KarpelesLab/multivolt/boards/lvl4/fab/lvl4_bottom.png

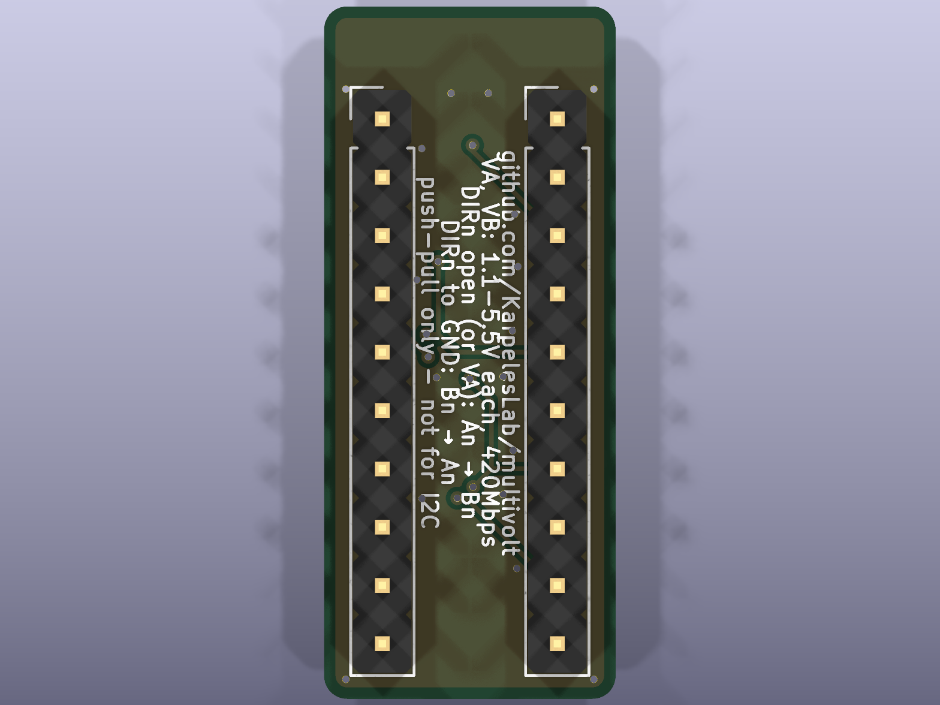
boards/lvl4/fab/lvl4_bottom.png
