KarpelesLab/multivolt/boards/lvl4/fab/lvl4_top.png

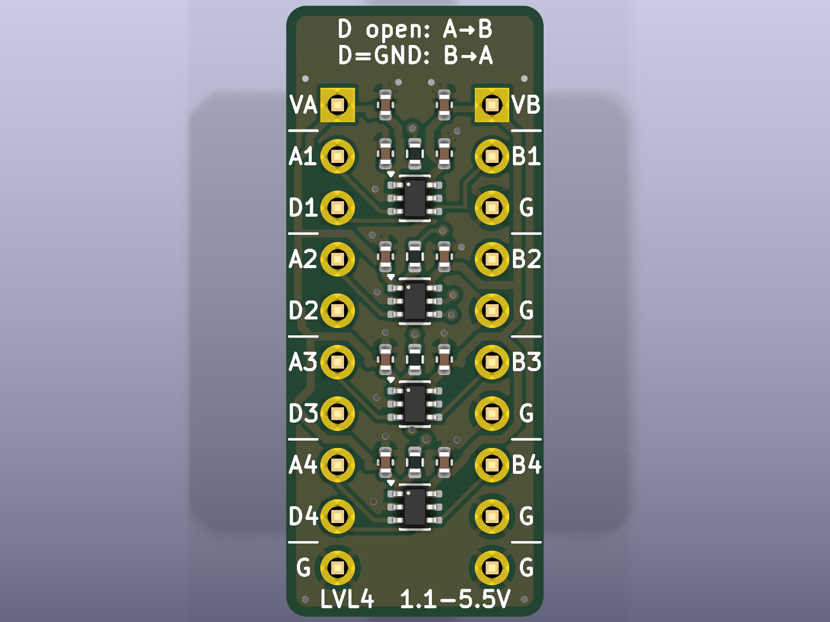
boards/lvl4/fab/lvl4_top.png
