KarpelesLab/multivolt/boards/mvpsu/fab/mvpsu_bottom.png

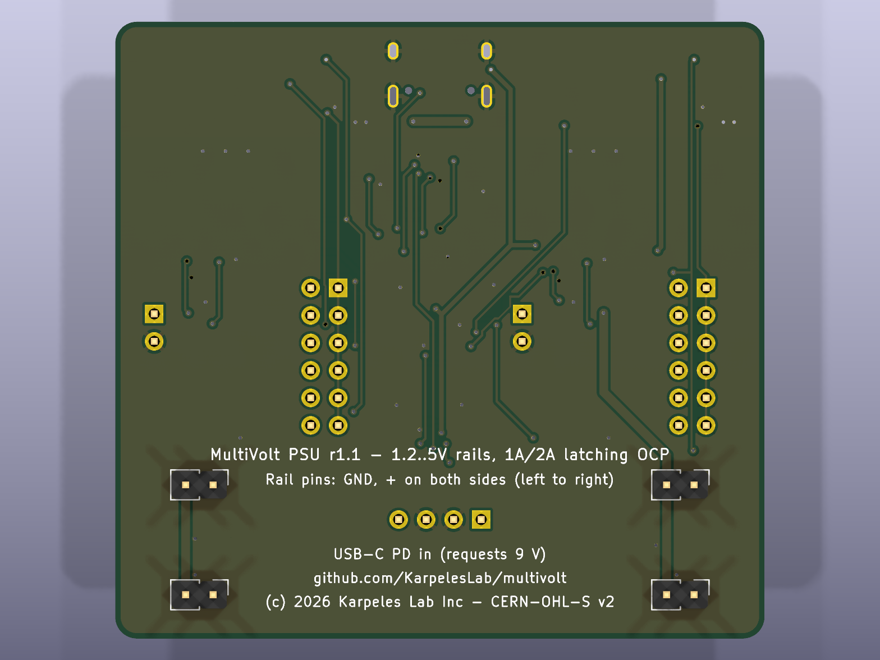
boards/mvpsu/fab/mvpsu_bottom.png
