KarpelesLab/multivolt/boards/mvpsu/fab/mvpsu_top.png

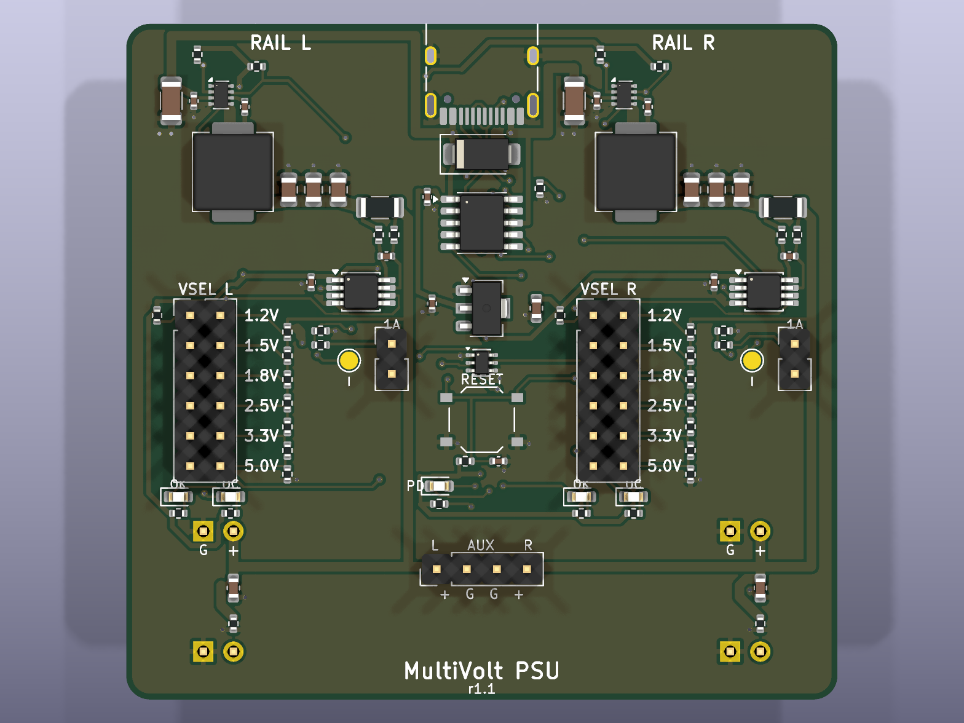
boards/mvpsu/fab/mvpsu_top.png
