KarpelesLab/multivolt/boards/mvpsu/fab/mvpsu_bom_jlc.csv

Comment | Designator | Footprint | LCSC Part #
USB-C | J1 | USB_C_Receptacle_HRO_TYPE-C-31-M-12 | C165948
SMAJ15A | D1 | D_SMA | C86819
CH224A | U1 | SSOP-10-1EP_3.9x4.9mm_P1mm_EP2.1x3.3mm | C42459160
1uF 25V | C1,C2 | C_0402_1005Metric | C52923
6.8k | R1 | R_0402_1005Metric | C25917
PD | D2 | LED_0603_1608Metric | C2287
1k | R2,R24,R27,R44,R47 | R_0402_1005Metric | C11702
HT7533-1 | U2 | SOT-89-3 | C14289
10uF | C3,C16,C36 | C_0603_1608Metric | C19702
2N7002DW | Q1 | SOT-363_SC-70-6 | C61840
RESET | SW1 | SW_Push_1P1T_XKB_TS-1187A | C318884
10k | R3 | R_0402_1005Metric | C25744
1uF | C4 | C_0402_1005Metric | C52923
TPS62933P | U3,U4 | SOT-583-8 | C5219254
22uF 25V | C10,C30 | C_1206_3216Metric | C12891
100nF | C11,C12,C17,C31,C32,C37 | C_0402_1005Metric | C1525
4.7uH | L1,L2 | L_Changjiang_FXL0630 | C167220
22uF 10V | C13,C14,C15,C33,C34,C35 | C_0805_2012Metric | C29277
50m | R10,R30 | R_1206_3216Metric | C127691
100k | R19,R20,R39,R40 | R_0402_1005Metric | C25741
INA301A1 | U5,U6 | VSSOP-8_3x3mm_P0.65mm | C471062
10 | R25,R26,R45,R46 | R_0402_1005Metric | C25077
4.7uF | C18,C38 | C_0402_1005Metric | C106859
24.9k | R21,R22,R41,R42 | R_0402_1005Metric | C138027
ILIM 1A | J11,J31 | PinHeader_1x02_P2.54mm_Vertical | C492401
6.34k | R11,R31 | R_0402_1005Metric | C5713274
2.43k | R12,R32 | R_0402_1005Metric | C830241
1.62k | R13,R33 | R_0402_1005Metric | C138038
2.26k | R14,R34 | R_0402_1005Metric | C226955
1.4k | R15,R35 | R_0402_1005Metric | C2974008
1.5k | R16,R36 | R_0402_1005Metric | C25867
2.94k | R17,R37 | R_0402_1005Metric | C42396634
1M | R18,R38 | R_0402_1005Metric | C26083
VSEL | J10,J30 | PinHeader_2x06_P2.54mm_Vertical | C492423
OK | D10,D30 | LED_0603_1608Metric | C2289
330 | R23,R43 | R_0402_1005Metric | C25104
OC | D11,D31 | LED_0603_1608Metric | C2286
RAIL L | J12,J13 | PinHeader_1x02_P2.54mm_Vertical | C492401
RAIL R | J32,J33 | PinHeader_1x02_P2.54mm_Vertical | C492401
AUX OUT | J2 | PinHeader_1x04_P2.54mm_Vertical | C2691448
