KarpelesLab/multivolt/boards/lvl4/fab/lvl4_bom_jlc.csv

Comment | Designator | Footprint | LCSC Part #
A side | J1 | PinHeader_1x10_P2.54mm_Vertical | C492409
B side | J2 | PinHeader_1x10_P2.54mm_Vertical | C492409
1uF | C1,C2 | C_0402_1005Metric | C52923
SN74LXC1T45DCK | U1,U2,U3,U4 | SOT-363_SC-70-6 | C5217888
100nF | C11,C12,C13,C14,C21,C22,C23,C24 | C_0402_1005Metric | C1525
100k | R1,R2,R3,R4 | R_0402_1005Metric | C25741
