KarpelesLab/multivolt/boards/mvpsu/fab/mvpsu_schematic.pdf

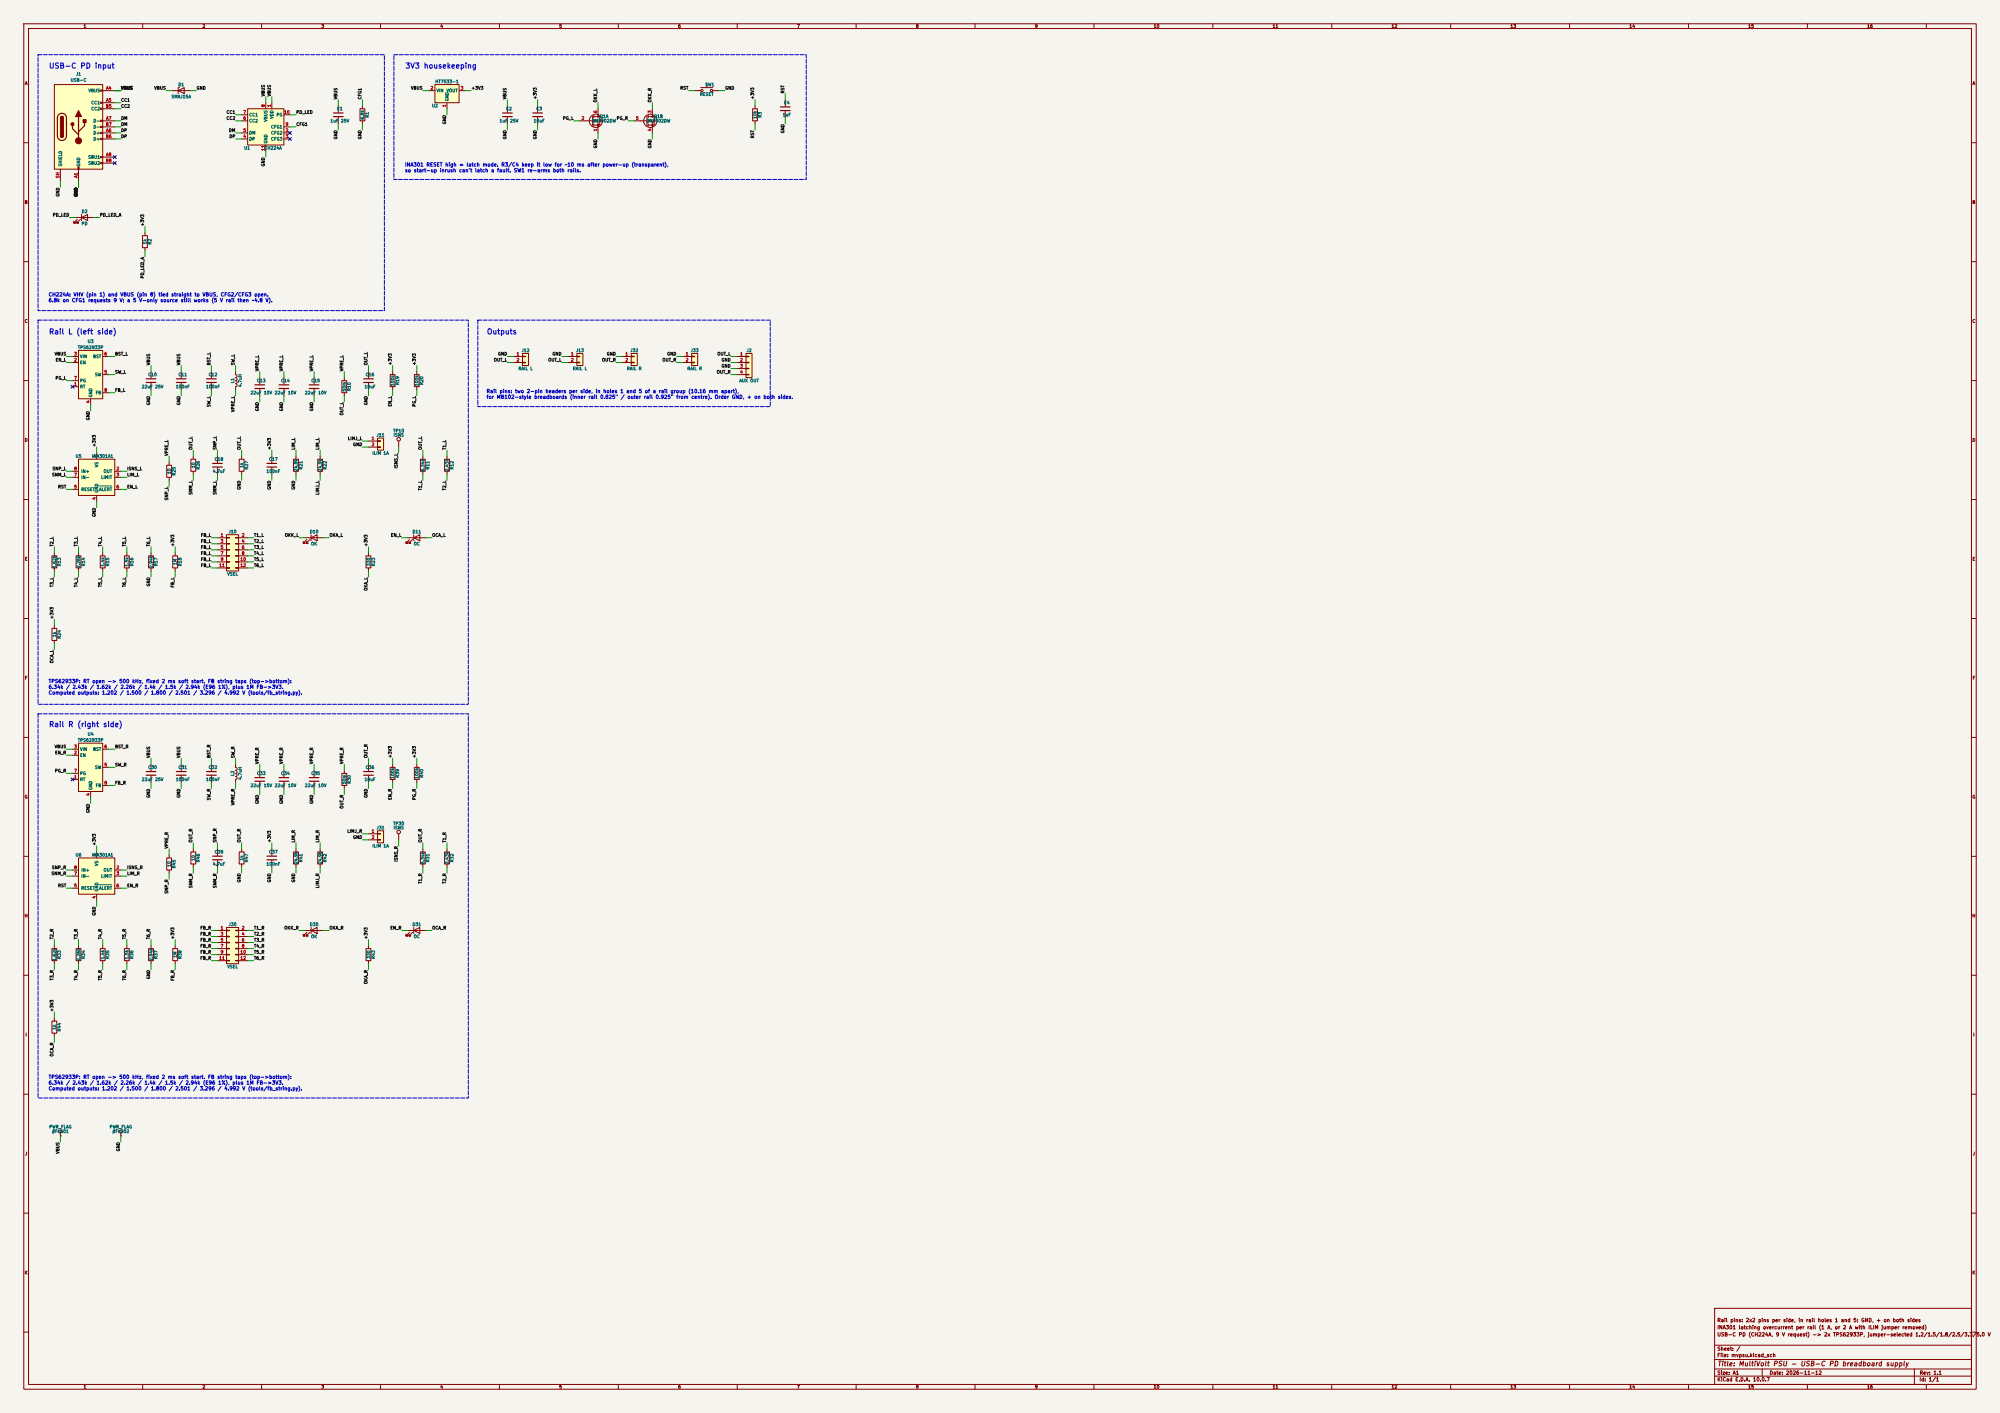
[picture p7: page 1]

INA301 RESET high = latch mode. R3/C4 keep it low for ~10 ms after power-up (transparent), so start-up inrush can't latch a fault. SW1 re-arms both rails.

CH224A: VHV (pin 1) and VBUS (pin 8) tied straight to VBUS, CFG2/CFG3 open.
6.8k on CFG1 requests 9 V; a 5 V-only source still works (5 V rail then ~4.8 V).

Rail pins: two 2-pin headers per side, in holes 1 and 5 of a rail group (10.16 mm apart),
for MB102-style breadboards (inner rail 0.825" / outer rail 0.925" from centre). Order GND, + on both sides.

TPS62933P: RT open -> 500 kHz, fixed 2 ms soft start. FB string taps (top->bottom):
6.34k / 2.43k / 1.62k / 2.26k / 1.4k / 1.5k / 2.94k (E96 1%), plus 1M FB->3V3.
Computed outputs: 1.202 / 1.500 / 1.800 / 2.501 / 3.296 / 4.992 V (tools/fb_string.py).

INA301 latching overcurrent per rail (1 A, or 2 A with ILIM jumper removed)
USB-C PD (CH224A, 9 V request) -> 2x TPS62933P, jumper-selected 1.2/1.5/1.8/2.5/3.3/5.0 V

Sheet: /
File: mvpsu.kicad_sch
Title: MultiVolt PSU - USB-C PD breadboard supply

Size: A1 | Rev: 1.1
KiCad E.D.A. 10.0.7 | Id: 1/1
