KarpelesLab/multivolt/boards/lvl4/fab/lvl4_schematic.pdf

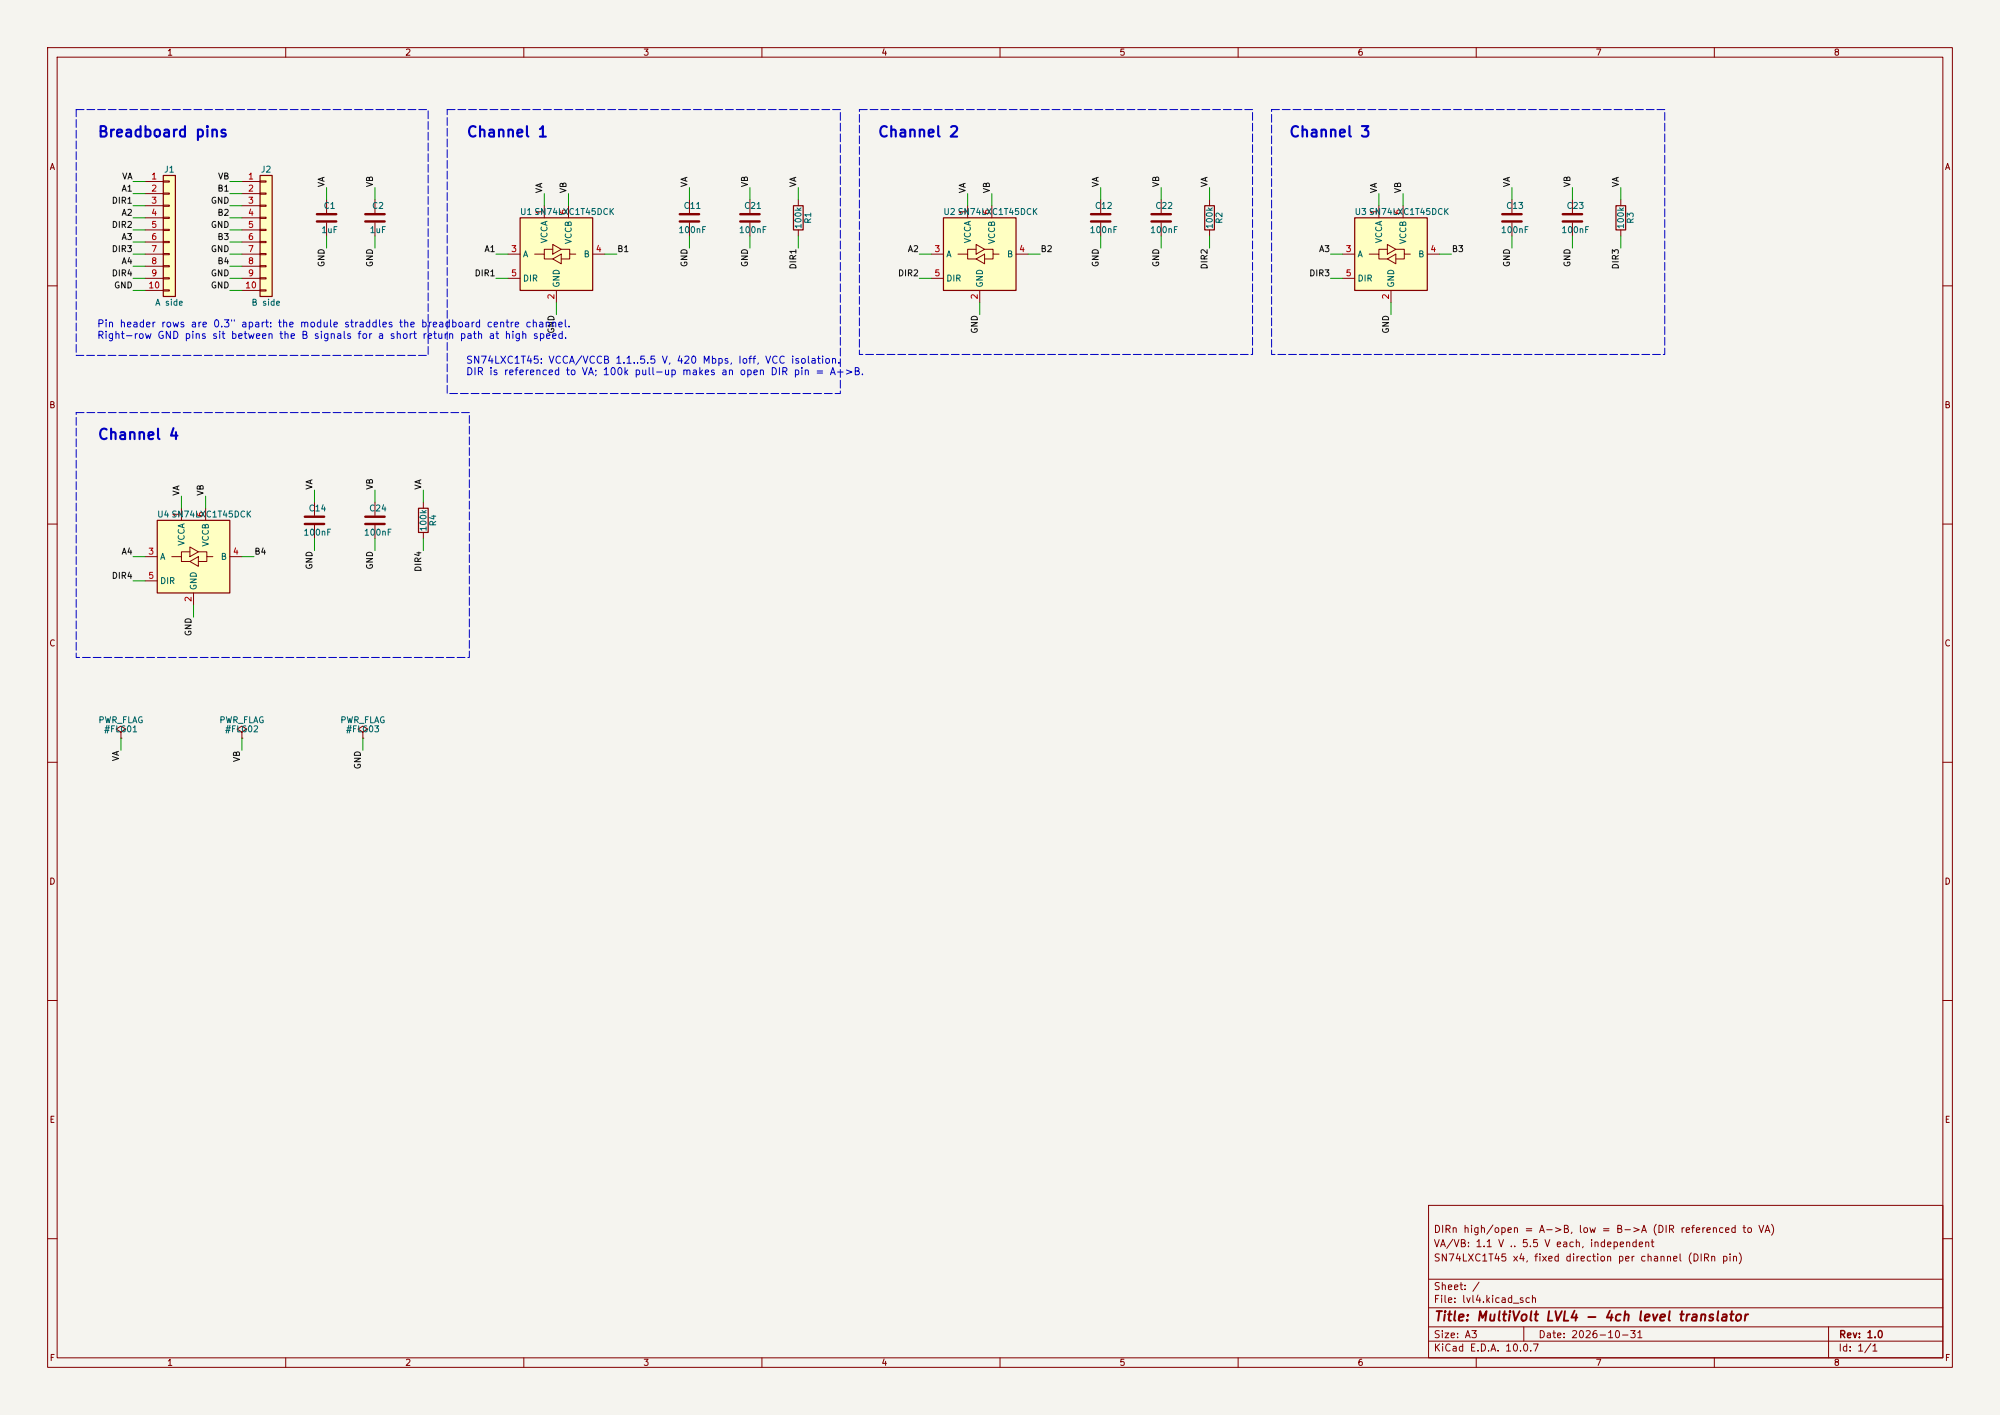
[picture p8: page 1]

Pin header rows are 0.3" apart: the module straddles the breadboard centre channel.
Right-row GND pins sit between the B signals for a short return path at high speed.

SN74LXC1T45: VCCA/VCCB 1.1..5.5 V, 420 Mbps, Ioff, VCC isolation.
DIR is referenced to VA; 100k pull-up makes an open DIR pin = A->B.

DIRn high/open = A->B, low = B->A (DIR referenced to VA)
VA/VB: 1.1 V .. 5.5 V each, independent
SN74LXC1T45 x4, fixed direction per channel (DIRn pin)

Sheet: /
File: lvl4.kicad_sch
Title: MultiVolt LVL4 - 4ch level translator

Size: A3 | Rev: 1.0 | F Date: 2026-10-31
KiCad E.D.A. 10.0.7 | Id: 1/1
