KarpelesLab/multivolt/boards/mvpsu/mvpsu.kicad_pcb

## KiCad design boards/mvpsu/mvpsu.kicad_pcb (2026-11-11)

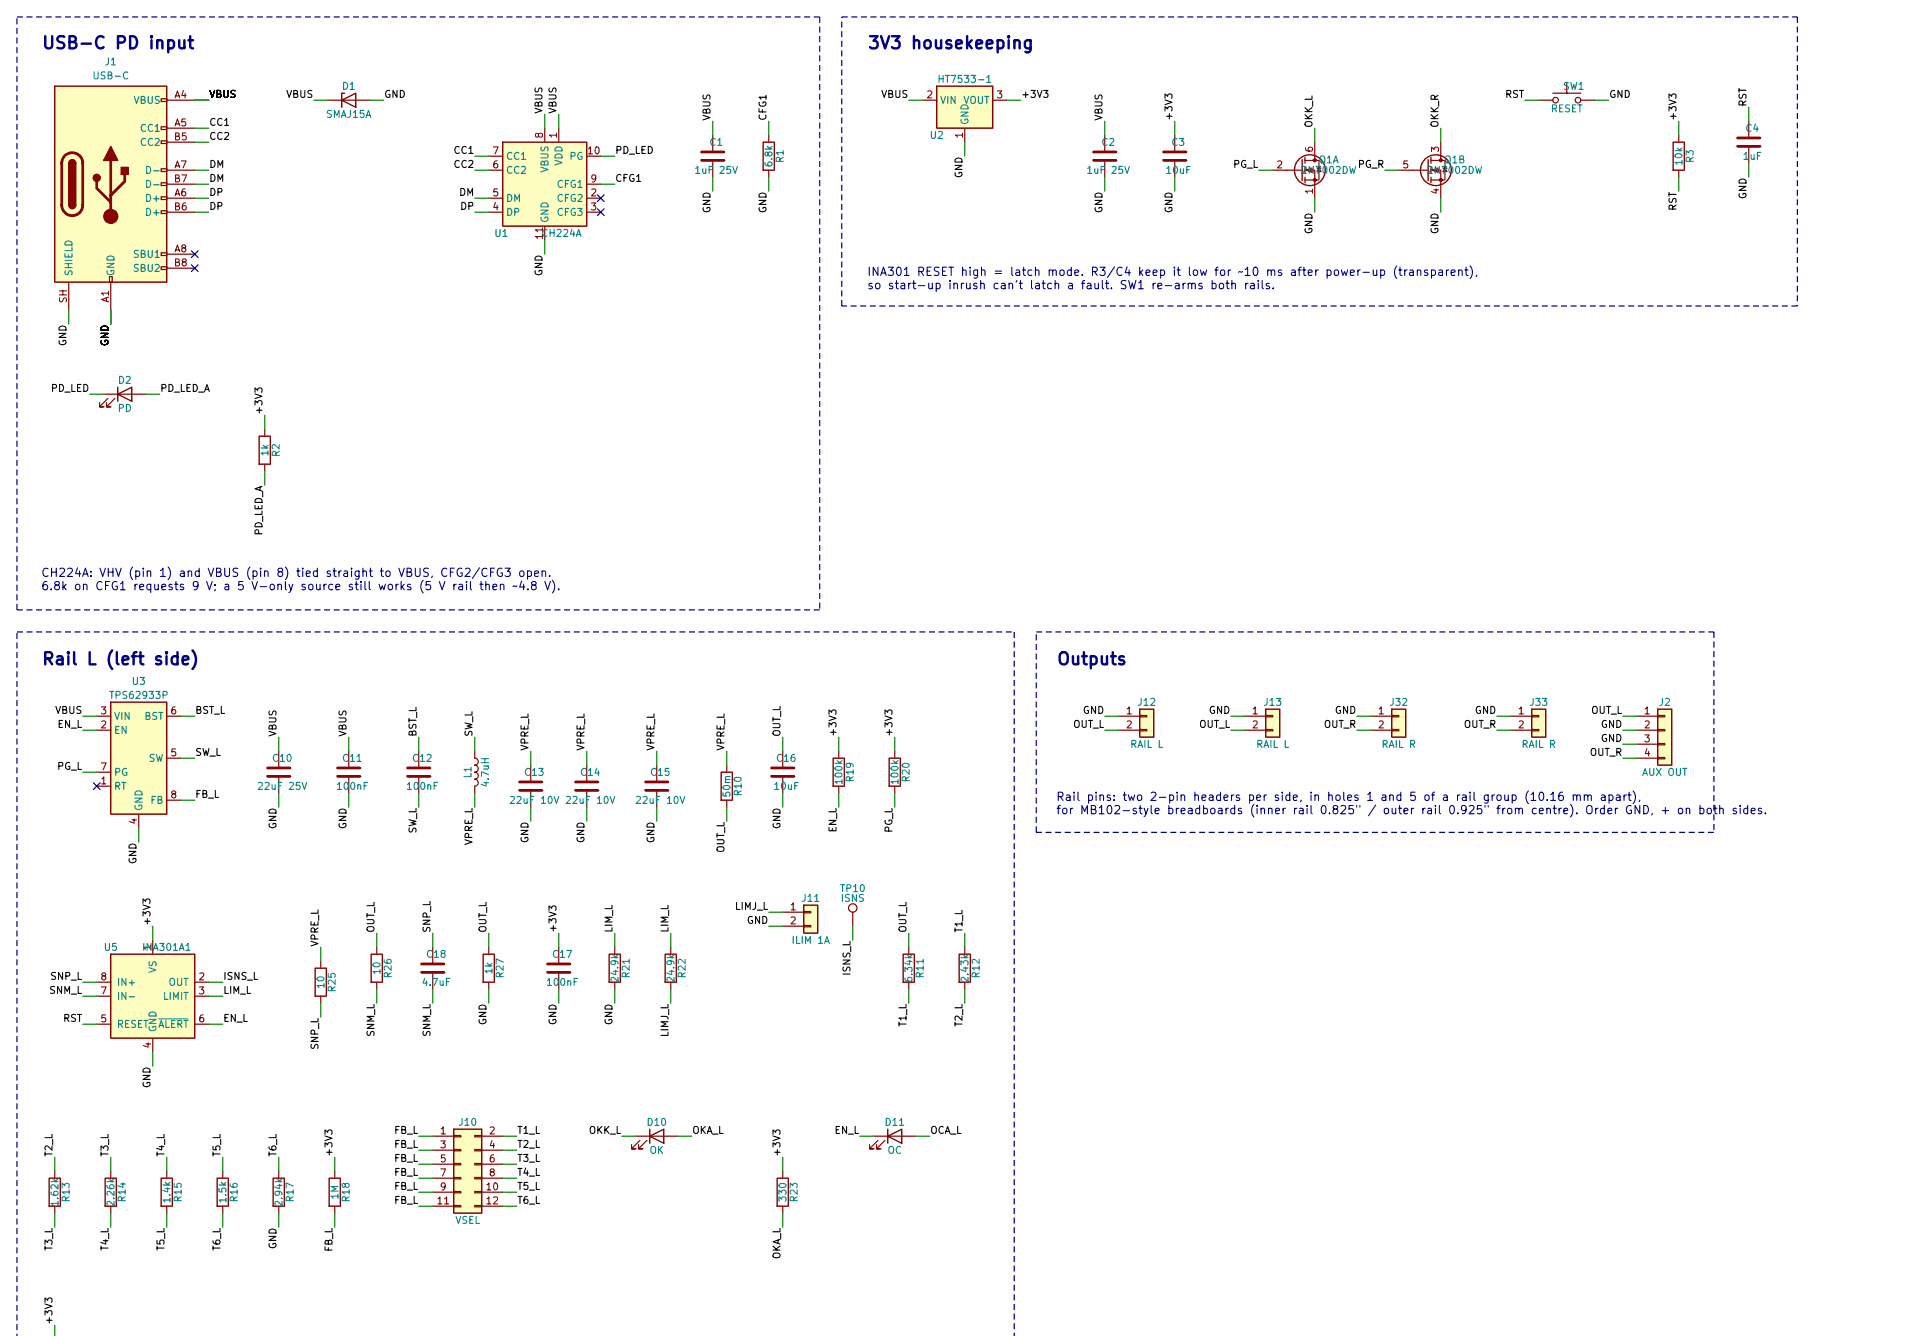
[picture p9: schematic mvpsu.kicad_sch, MultiVolt PSU - USB-C PD breadboard supply, part in row 1, column 1]

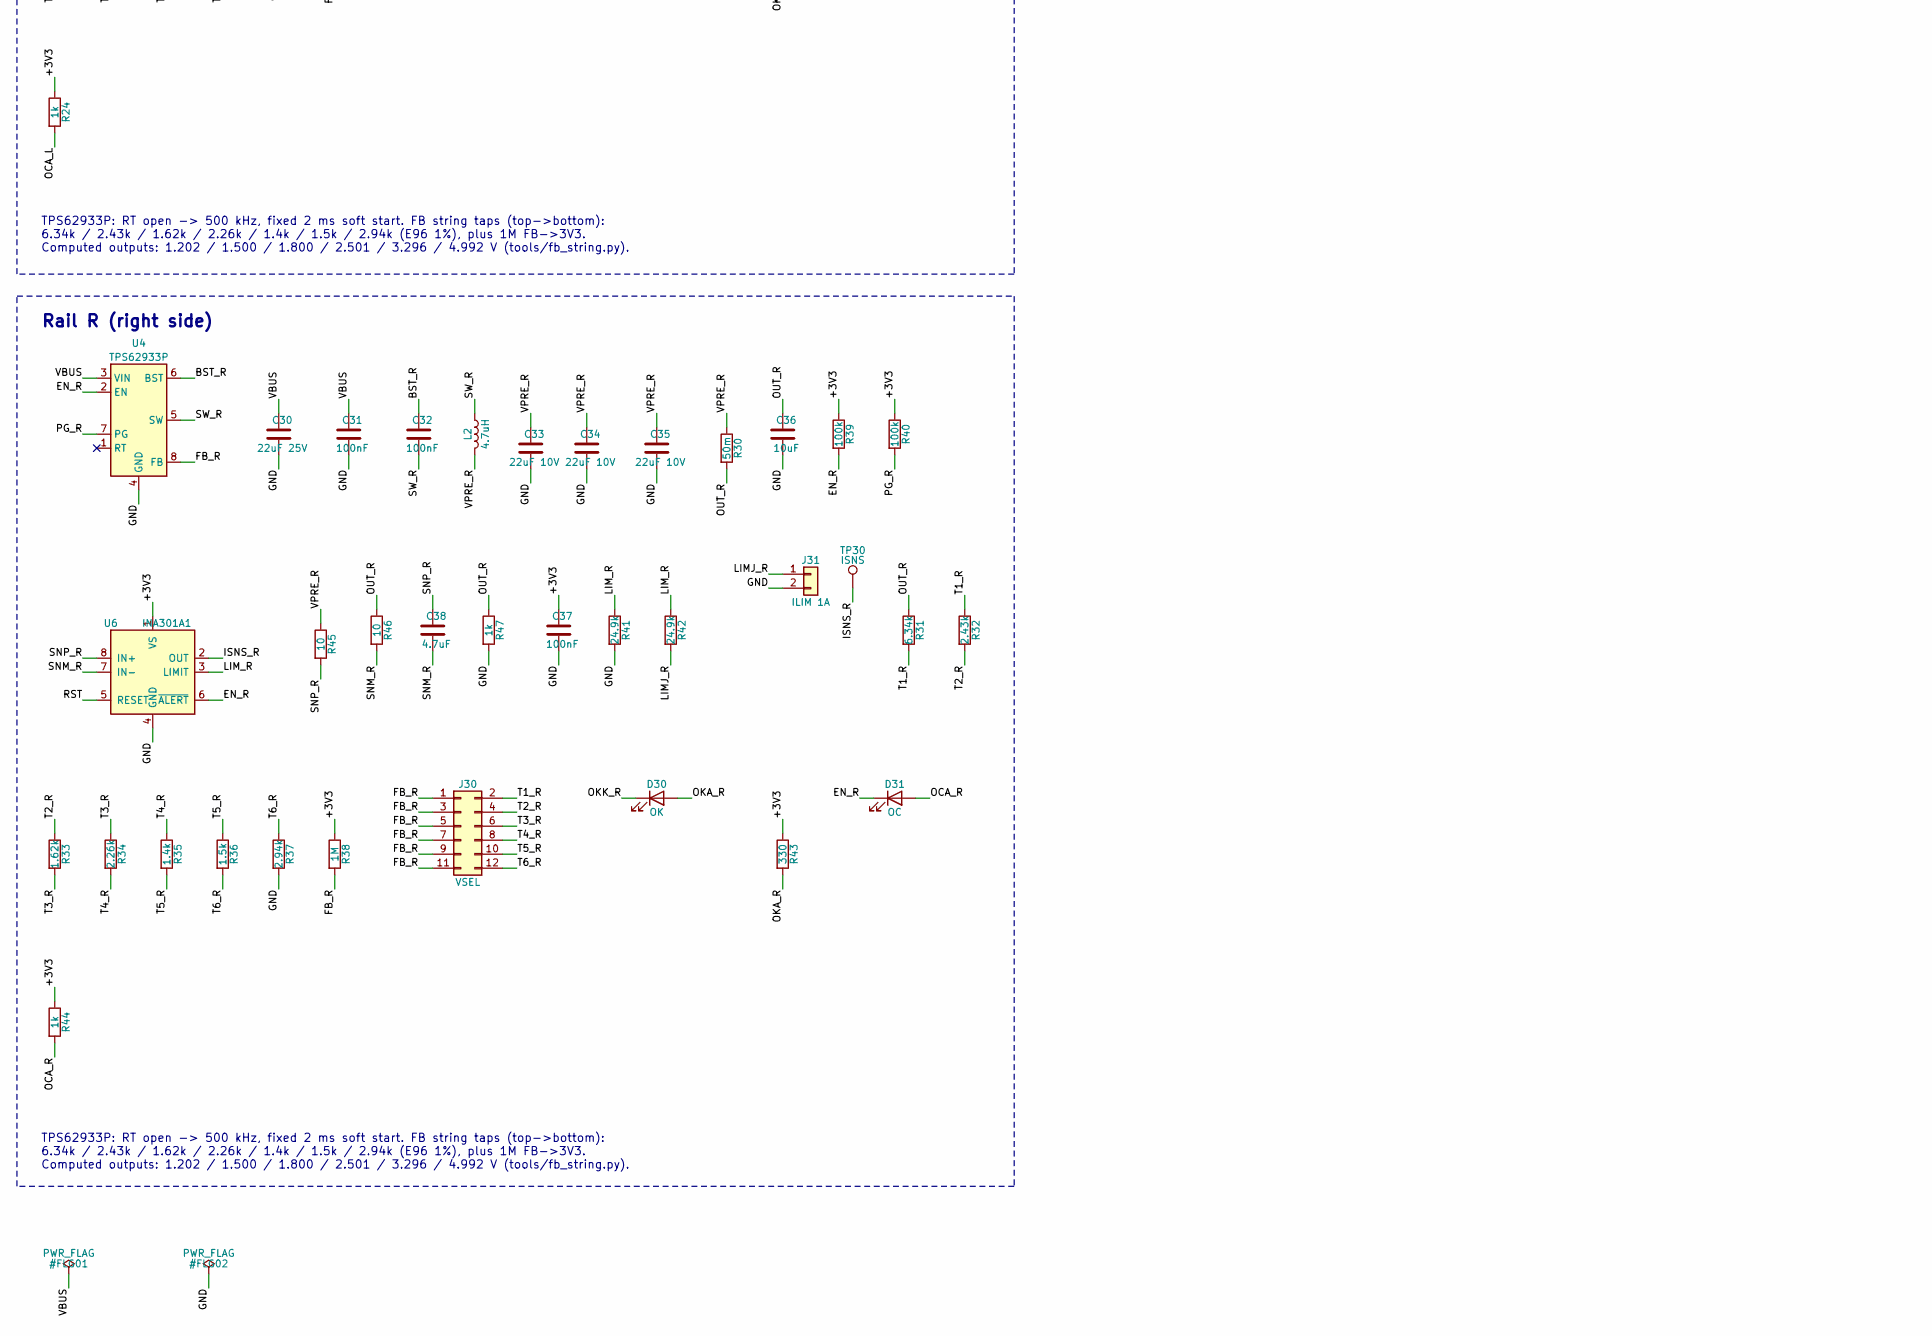
[picture p10: schematic mvpsu.kicad_sch, MultiVolt PSU - USB-C PD breadboard supply, part in row 2, column 1]

Parts:
C1, C2: 1uF 25V; C_0402_1005Metric; LCSC C52923
C3, C16, C36: 10uF; C_0603_1608Metric; LCSC C19702
C4: 1uF; C_0402_1005Metric; LCSC C52923
C10, C30: 22uF 25V; C_1206_3216Metric; LCSC C12891
C11, C12, C17, C31, C32, C37: 100nF; C_0402_1005Metric; LCSC C1525
C13, C14, C15, C33, C34, C35: 22uF 10V; C_0805_2012Metric; LCSC C29277
C18, C38: 4.7uF; C_0402_1005Metric; LCSC C106859
D1: SMAJ15A; D_SMA; LCSC C86819
D2: PD; LED_0603_1608Metric; MPN KT-0603Y; LCSC C2287
D10, D30: OK; LED_0603_1608Metric; MPN KT-0603YG; LCSC C2289
D11, D31: OC; LED_0603_1608Metric; MPN KT-0603R; LCSC C2286
J1: USB-C; USB_C_Receptacle_HRO_TYPE-C-31-M-12; MPN TYPE-C-31-M-12; LCSC C165948
J2: AUX OUT; PinHeader_1x04_P2.54mm_Vertical; LCSC C2691448
J10, J30: VSEL; PinHeader_2x06_P2.54mm_Vertical; LCSC C492423
J11, J31: ILIM 1A; PinHeader_1x02_P2.54mm_Vertical; LCSC C492401
J12, J13: RAIL L; PinHeader_1x02_P2.54mm_Vertical; LCSC C492401
J32, J33: RAIL R; PinHeader_1x02_P2.54mm_Vertical; LCSC C492401
L1, L2: 4.7uH; L_Changjiang_FXL0630; MPN FXL0630-4R7-M; LCSC C167220
Q1: 2N7002DW; SOT-363_SC-70-6; LCSC C61840
R1: 6.8k; R_0402_1005Metric; LCSC C25917
R2, R24, R27, R44, R47: 1k; R_0402_1005Metric; LCSC C11702
R3: 10k; R_0402_1005Metric; LCSC C25744
R10, R30: 50m; R_1206_3216Metric; LCSC C127691
R11, R31: 6.34k; R_0402_1005Metric; LCSC C5713274
R12, R32: 2.43k; R_0402_1005Metric; LCSC C830241
R13, R33: 1.62k; R_0402_1005Metric; LCSC C138038
R14, R34: 2.26k; R_0402_1005Metric; LCSC C226955
R15, R35: 1.4k; R_0402_1005Metric; LCSC C2974008
R16, R36: 1.5k; R_0402_1005Metric; LCSC C25867
R17, R37: 2.94k; R_0402_1005Metric; LCSC C42396634
R18, R38: 1M; R_0402_1005Metric; LCSC C26083
R19, R20, R39, R40: 100k; R_0402_1005Metric; LCSC C25741
R21, R22, R41, R42: 24.9k; R_0402_1005Metric; LCSC C138027
R23, R43: 330; R_0402_1005Metric; LCSC C25104
R25, R26, R45, R46: 10; R_0402_1005Metric; LCSC C25077
SW1: RESET; SW_Push_1P1T_XKB_TS-1187A; LCSC C318884
TP10, TP30: ISNS; TestPoint_Pad_D1.5mm
U1: CH224A; SSOP-10-1EP_3.9x4.9mm_P1mm_EP2.1x3.3mm; MPN CH224A; LCSC C42459160
U2: HT7533-1; SOT-89-3; LCSC C14289
U3, U4: TPS62933P; SOT-583-8; MPN TPS62933PDRLR; LCSC C5219254
U5, U6: INA301A1; VSSOP-8_3x3mm_P0.65mm; MPN INA301A1IDGKR; LCSC C471062

Connections:
+3V3: C3.1, C17.1, C37.1, R2.1, R3.1, R18.1, R19.1, R20.1, R23.1, R24.1, R38.1, R39.1, R40.1, R43.1, R44.1, U2.3 (VOUT), U5.1 (VS), U6.1 (VS)
BST_L: C12.1, U3.6 (BST)
BST_R: C32.1, U4.6 (BST)
CC1: J1.A5 (CC1), U1.7 (CC1)
CC2: J1.B5 (CC2), U1.6 (CC2)
CFG1: R1.1, U1.9 (CFG1)
DM: J1.A7 (D-), J1.B7 (D-), U1.5 (DM)
DP: J1.A6 (D+), J1.B6 (D+), U1.4 (DP)
EN_L: D11.1 (K), R19.2, U3.2 (EN), U5.6 (~ALERT)
EN_R: D31.1 (K), R39.2, U4.2 (EN), U6.6 (~ALERT)
FB_L: J10.1, J10.3, J10.5, J10.7, J10.9, J10.11, R18.2, U3.8 (FB)
FB_R: J30.1, J30.3, J30.5, J30.7, J30.9, J30.11, R38.2, U4.8 (FB)
GND: C1.2, C2.2, C3.2, C4.2, C10.2, C11.2, C13.2, C14.2, C15.2, C16.2, C17.2, C30.2, C31.2, C33.2, C34.2, C35.2, C36.2, C37.2, D1.2 (A), J1.A1 (GND), J1.A12 (GND), J1.B1 (GND), J1.B12 (GND), J1.SH (SHIELD), J2.2, J2.3, J11.2, J12.1, J13.1, J31.2, J32.1, J33.1, Q1.1 (S), Q1.4 (S), R1.2, R17.2, R21.2, R27.2, R37.2, R41.2, R47.2, SW1.2, U1.11 (GND), U2.1 (GND), U3.4 (GND), U4.4 (GND), U5.4 (GND), U6.4 (GND)
ISNS_L: TP10.1, U5.2 (OUT)
ISNS_R: TP30.1, U6.2 (OUT)
LIMJ_L: J11.1, R22.2
LIMJ_R: J31.1, R42.2
LIM_L: R21.1, R22.1, U5.3 (LIMIT)
LIM_R: R41.1, R42.1, U6.3 (LIMIT)
OCA_L: D11.2 (A), R24.2
OCA_R: D31.2 (A), R44.2
OKA_L: D10.2 (A), R23.2
OKA_R: D30.2 (A), R43.2
OKK_L: D10.1 (K), Q1.6 (D)
OKK_R: D30.1 (K), Q1.3 (D)
OUT_L: C16.1, J2.1, J12.2, J13.2, R10.2, R11.1, R26.1, R27.1
OUT_R: C36.1, J2.4, J32.2, J33.2, R30.2, R31.1, R46.1, R47.1
PD_LED: D2.1 (K), U1.10 (PG)
PD_LED_A: D2.2 (A), R2.2
PG_L: Q1.2 (G), R20.2, U3.7 (PG)
PG_R: Q1.5 (G), R40.2, U4.7 (PG)
RST: C4.1, R3.2, SW1.1, U5.5 (RESET), U6.5 (RESET)
SNM_L: C18.2, R26.2, U5.7 (IN-)
SNM_R: C38.2, R46.2, U6.7 (IN-)
SNP_L: C18.1, R25.2, U5.8 (IN+)
SNP_R: C38.1, R45.2, U6.8 (IN+)
SW_L: C12.2, L1.1, U3.5 (SW)
SW_R: C32.2, L2.1, U4.5 (SW)
T1_L: J10.2, R11.2, R12.1
T1_R: J30.2, R31.2, R32.1
T2_L: J10.4, R12.2, R13.1
T2_R: J30.4, R32.2, R33.1
T3_L: J10.6, R13.2, R14.1
T3_R: J30.6, R33.2, R34.1
T4_L: J10.8, R14.2, R15.1
T4_R: J30.8, R34.2, R35.1
T5_L: J10.10, R15.2, R16.1
T5_R: J30.10, R35.2, R36.1
T6_L: J10.12, R16.2, R17.1
T6_R: J30.12, R36.2, R37.1
VBUS: C1.1, C2.1, C10.1, C11.1, C30.1, C31.1, D1.1 (K), J1.A4 (VBUS), J1.A9 (VBUS), J1.B4 (VBUS), J1.B9 (VBUS), U1.1 (VDD), U1.8 (VBUS), U2.2 (VIN), U3.3 (VIN), U4.3 (VIN)
VPRE_L: C13.1, C14.1, C15.1, L1.2, R10.1, R25.1
VPRE_R: C33.1, C34.1, C35.1, L2.2, R30.1, R45.1

Notes on the sheet:
USB-C PD input
CH224A: VHV (pin 1) and VBUS (pin 8) tied straight to VBUS, CFG2/CFG3 open. 6.8k on CFG1 requests 9 V; a 5 V-only source still works (5 V rail then ~4.8 V).
3V3 housekeeping
INA301 RESET high = latch mode. R3/C4 keep it low for ~10 ms after power-up (transparent), so start-up inrush can't latch a fault. SW1 re-arms both rails.
Rail L (left side)
TPS62933P: RT open -> 500 kHz, fixed 2 ms soft start. FB string taps (top->bottom): 6.34k / 2.43k / 1.62k / 2.26k / 1.4k / 1.5k / 2.94k (E96 1%), plus 1M FB->3V3. Computed outputs: 1.202 / 1.500 / 1.800 / 2.501 / 3.296 / 4.992 V (tools/fb_string.py).
Outputs
Rail pins: two 2-pin headers per side, in holes 1 and 5 of a rail group (10.16 mm apart), for MB102-style breadboards (inner rail 0.825" / outer rail 0.925" from centre). Order GND, + on both sides.
Rail R (right side)

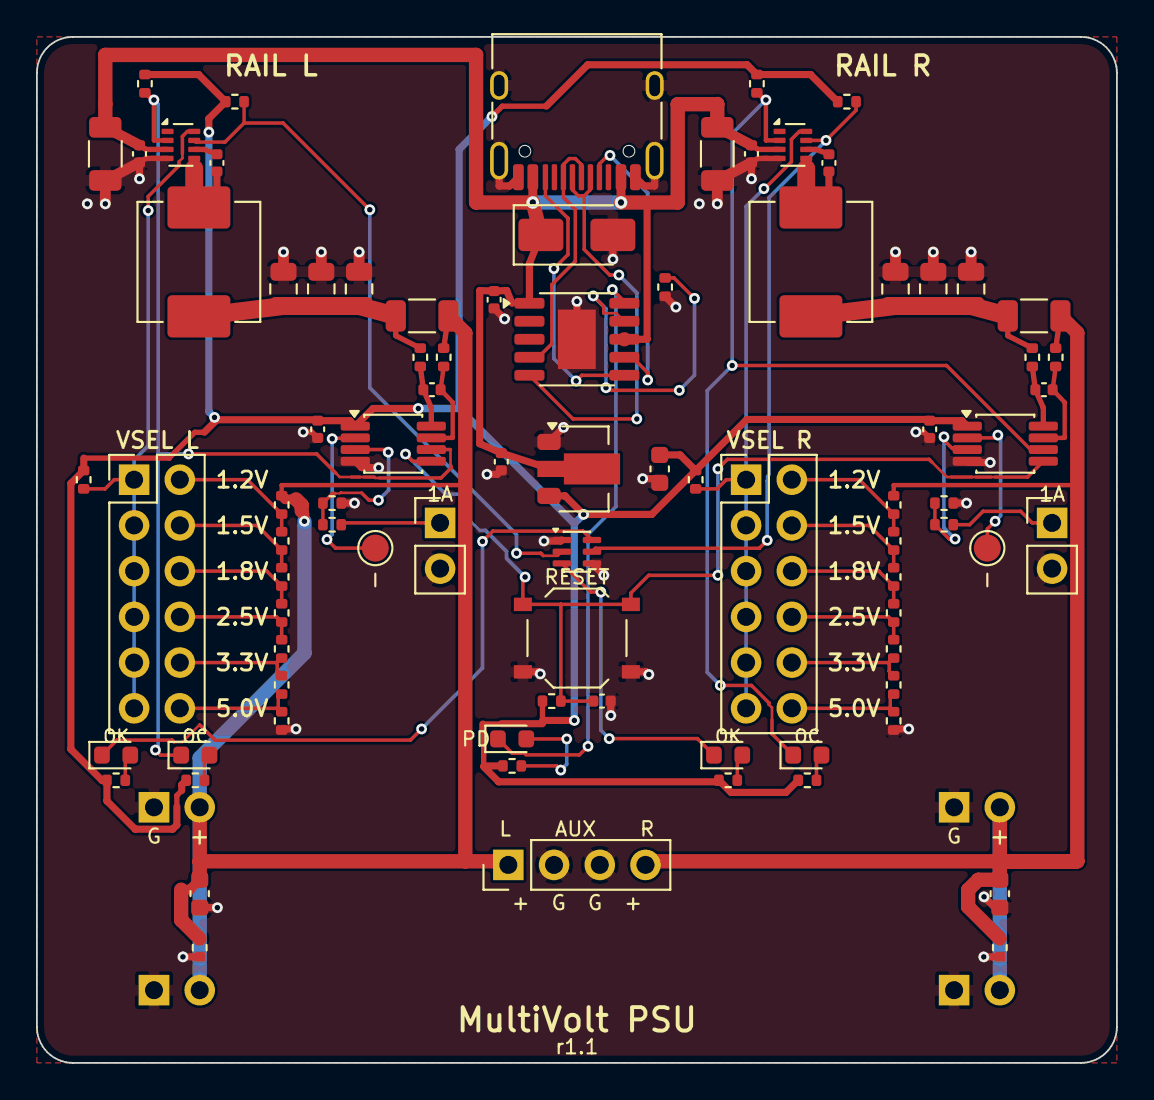
[picture p11: board mvpsu.kicad_pcb from above]

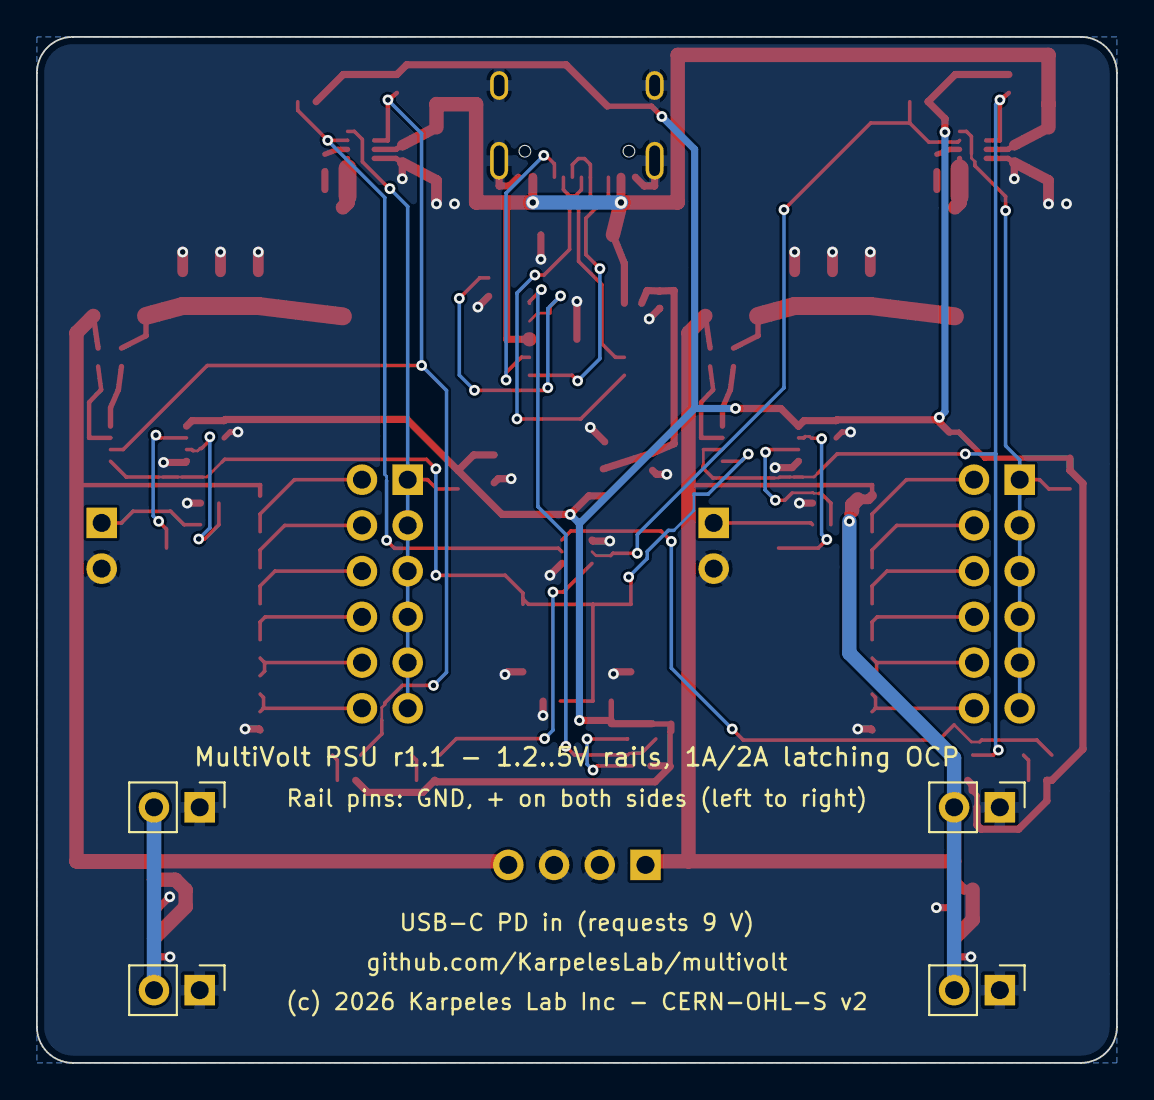
[picture p12: board mvpsu.kicad_pcb from below]

Board: 2 copper layers, 60.0 x 57.0 mm, 89 parts (4 on the bottom side), 53 nets.
