KarpelesLab/multivolt/boards/lvl4/lvl4.kicad_pcb

## KiCad design boards/lvl4/lvl4.kicad_pcb (2026-10-31)

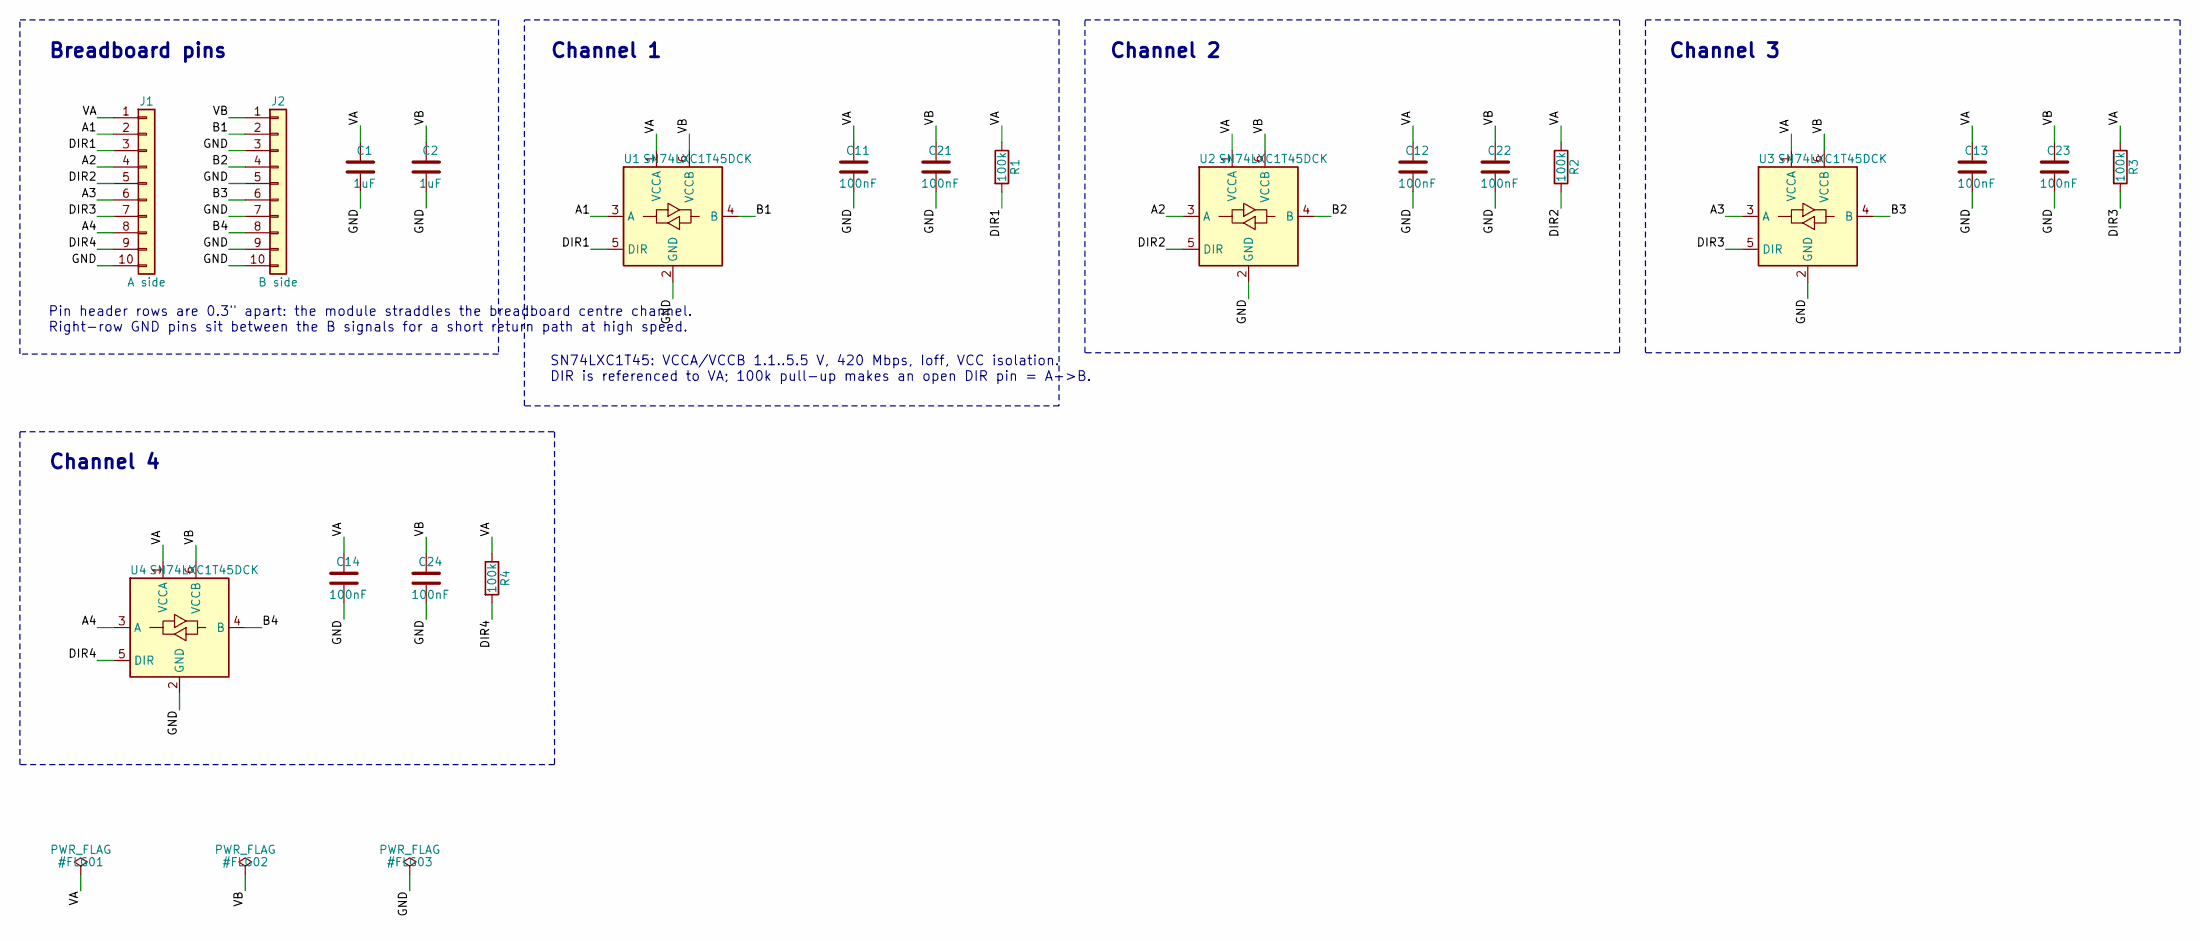
[picture p13: schematic lvl4.kicad_sch, MultiVolt LVL4 - 4ch level translator]

Parts:
C1, C2: 1uF; C_0402_1005Metric; LCSC C52923
C11, C12, C13, C14, C21, C22, C23, C24: 100nF; C_0402_1005Metric; LCSC C1525
J1: A side; PinHeader_1x10_P2.54mm_Vertical; LCSC C492409
J2: B side; PinHeader_1x10_P2.54mm_Vertical; LCSC C492409
R1, R2, R3, R4: 100k; R_0402_1005Metric; LCSC C25741
U1, U2, U3, U4: SN74LXC1T45DCK; SOT-363_SC-70-6; MPN SN74LXC1T45DCKR; LCSC C5217888

Connections:
A1: J1.2, U1.3 (A)
A2: J1.4, U2.3 (A)
A3: J1.6, U3.3 (A)
A4: J1.8, U4.3 (A)
B1: J2.2, U1.4 (B)
B2: J2.4, U2.4 (B)
B3: J2.6, U3.4 (B)
B4: J2.8, U4.4 (B)
DIR1: J1.3, R1.2, U1.5 (DIR)
DIR2: J1.5, R2.2, U2.5 (DIR)
DIR3: J1.7, R3.2, U3.5 (DIR)
DIR4: J1.9, R4.2, U4.5 (DIR)
GND: C1.2, C2.2, C11.2, C12.2, C13.2, C14.2, C21.2, C22.2, C23.2, C24.2, J1.10, J2.3, J2.5, J2.7, J2.9, J2.10, U1.2 (GND), U2.2 (GND), U3.2 (GND), U4.2 (GND)
VA: C1.1, C11.1, C12.1, C13.1, C14.1, J1.1, R1.1, R2.1, R3.1, R4.1, U1.1 (VCCA), U2.1 (VCCA), U3.1 (VCCA), U4.1 (VCCA)
VB: C2.1, C21.1, C22.1, C23.1, C24.1, J2.1, U1.6 (VCCB), U2.6 (VCCB), U3.6 (VCCB), U4.6 (VCCB)

Notes on the sheet:
Breadboard pins
Pin header rows are 0.3" apart: the module straddles the breadboard centre channel. Right-row GND pins sit between the B signals for a short return path at high speed.
Channel 1
SN74LXC1T45: VCCA/VCCB 1.1..5.5 V, 420 Mbps, Ioff, VCC isolation. DIR is referenced to VA; 100k pull-up makes an open DIR pin = A->B.
Channel 2
Channel 3
Channel 4

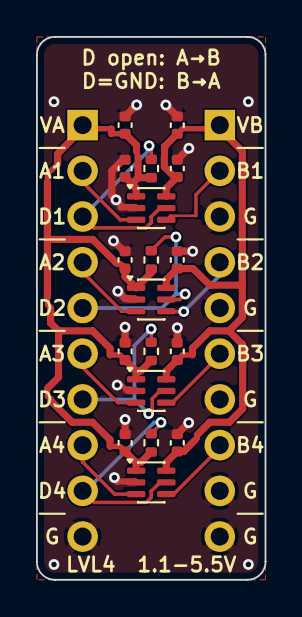
[picture p14: board lvl4.kicad_pcb from above]

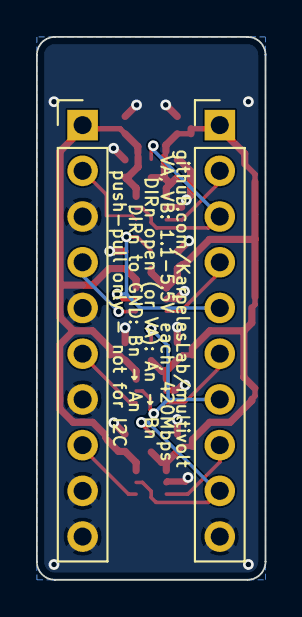
[picture p15: board lvl4.kicad_pcb from below]

Board: 2 copper layers, 12.7 x 30.2 mm, 20 parts (2 on the bottom side), 15 nets.
