KarpelesLab/multivolt/(commit log)

2026-10-31 MultiVolt: USB-C PD breadboard PSU and 4-channel level translator
    Two JLCPCB-ready KiCad 10 boards generated from Python descriptions:
    - mvpsu: CH224A PD sink (9 V) feeding two TPS62933P bucks, jumper-selected
    1.2/1.5/1.8/2.5/3.3/5.0 V per breadboard rail, INA301 latching overcurrent
    (1 A / 2 A), PD/OK/OC LEDs, rail pins for 1.5"/1.6"/1.7" breadboards.
    - lvl4: 4x SN74LXC1T45 fixed-direction translators in a DIP-20 footprint.
    Includes the generator (schematic writer, PCB builder, Freerouting
    autoroute, DRC/parity checks, JLC BOM/CPL export) and fabrication outputs.
    [lvl4-B_Cu.gbl, lvl4-B_Mask.gbs, lvl4-B_Paste.gbp, lvl4-B_Silkscreen.gbo, lvl4-Edge_Cuts.gm1, lvl4-F_Cu.gtl, lvl4-F_Mask.gts, lvl4-F_Paste.gtp]
2026-10-31 PSU: fixed breadboard rail pins, GND/+ same order on both sides
    - Replace the three rail-spacing footprint options with a single layout
    for MB102-style breadboards: inner rail 0.85", outer rail 0.95" from
    centre (on the 0.1" grid).
    - Two 2-pin headers per side, 5 holes (12.7 mm) apart along the rail.
    - GND, + order on both sides (RAIL_ORDER setting to flip).
    - Output cap and bleeder moved next to the + pins; LEDs shifted up.
    [mvpsu-B_Cu.gbl, mvpsu-B_Mask.gbs, mvpsu-B_Paste.gbp, mvpsu-B_Silkscreen.gbo, mvpsu-Edge_Cuts.gm1, mvpsu-F_Cu.gtl, mvpsu-F_Mask.gts, mvpsu-F_Paste.gtp]
2026-10-31 LVL4: clearer silkscreen with direction legend
    - Direction rule on the front ("D open: A->B", "D=GND: B->A"); board
    grows 2 mm at the top (12.7 x 30 mm) to fit it.
    - Larger pin labels and divider lines grouping each channel.
    - Full usage legend on the back between the header bodies.
    - pcbgen: support silkscreen line segments.
    [lvl4-B_Cu.gbl, lvl4-B_Mask.gbs, lvl4-B_Paste.gbp, lvl4-B_Silkscreen.gbo, lvl4-Edge_Cuts.gm1, lvl4-F_Cu.gtl, lvl4-F_Mask.gts, lvl4-F_Paste.gtp]
2026-10-31 License under CERN-OHL-S v2, add source location to silkscreen
    - Add CERN-OHL-S v2 LICENSE and a license section in the README.
    - PSU back silkscreen: repository URL and copyright/licence line.
    - LVL4 back silkscreen: repository URL.
    [lvl4-B_Cu.gbl, lvl4-B_Mask.gbs, lvl4-B_Paste.gbp, lvl4-B_Silkscreen.gbo, lvl4-Edge_Cuts.gm1, lvl4-F_Cu.gtl, lvl4-F_Mask.gts, lvl4-F_Paste.gtp]
2026-11-04 PSU: copyright to Karpeles Lab Inc, move back silkscreen clear of holes
    Back-side text overlapped the VSEL/ILIM header holes; moved it to the
    free area around the AUX header. Regenerated fab outputs.
    [mvpsu-B_Cu.gbl, mvpsu-B_Mask.gbs, mvpsu-B_Paste.gbp, mvpsu-B_Silkscreen.gbo, mvpsu-Edge_Cuts.gm1, mvpsu-F_Cu.gtl, mvpsu-F_Mask.gts, mvpsu-F_Paste.gtp]
2026-11-04 JLC CPL: rotation fixes and pad-centred connectors, Linux tool fallback
    Rotations confirmed in JLC's placement preview: pin headers +90,
    TS-1187A +180, SSOP-10/SOT-583/VSSOP-8 +270, SOT-89 +180. Pin headers,
    USB-C and SOT-89 are placed on their pad centre, since their KiCad
    origin isn't the part centre. kcli/fab.sh fall back to kicad-cli and
    python3 from PATH when the macOS KiCad install isn't there.
    [mvpsu_cpl_jlc.csv]
2026-11-04 JLC CPL: SOT-363 +180, regenerate LVL4 placement
    Q1 (2N7002DW) and the LVL4 SN74LXC1T45 chips both showed 180 degrees off
    in JLC's preview. LVL4 placement also picks up the pin-header rotation
    and pad-centre fixes.
    [lvl4_cpl_jlc.csv, mvpsu_cpl_jlc.csv]
2026-11-11 PSU r1.1: rail pins 1.27 mm closer together, rows in rail holes 1 and 5
    Test fit of r1.0 showed the two rail pairs sit half a pitch closer than
    assumed (each side moved in 0.635 mm), and the second pin row landed on
    the blank position between rail groups (hole 6 instead of 5).
    [mvpsu-B_Cu.gbl, mvpsu-B_Mask.gbs, mvpsu-B_Paste.gbp, mvpsu-B_Silkscreen.gbo, mvpsu-Edge_Cuts.gm1, mvpsu-F_Cu.gtl, mvpsu-F_Mask.gts, mvpsu-F_Paste.gtp]
